LZ1DPN/NorCal-NC40a/26992727_10215181009948796_1139771007666521038_n.jpg

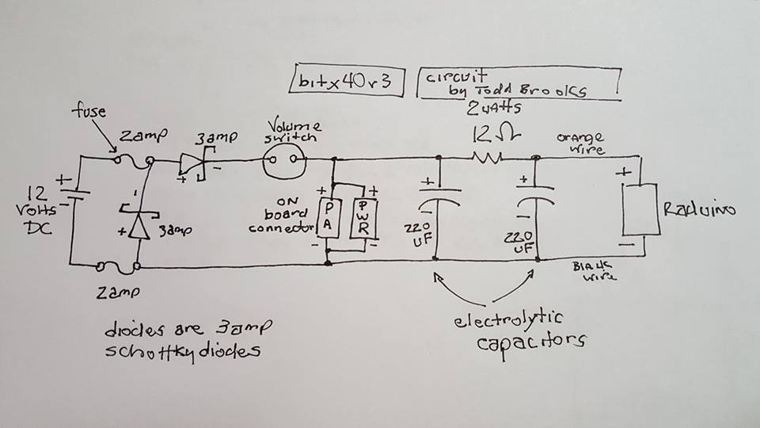
26992727_10215181009948796_1139771007666521038_n.jpg
