LZ1DPN/NorCal-NC40a/57180155_10156552755973757_5705052471420780544_n.jpg

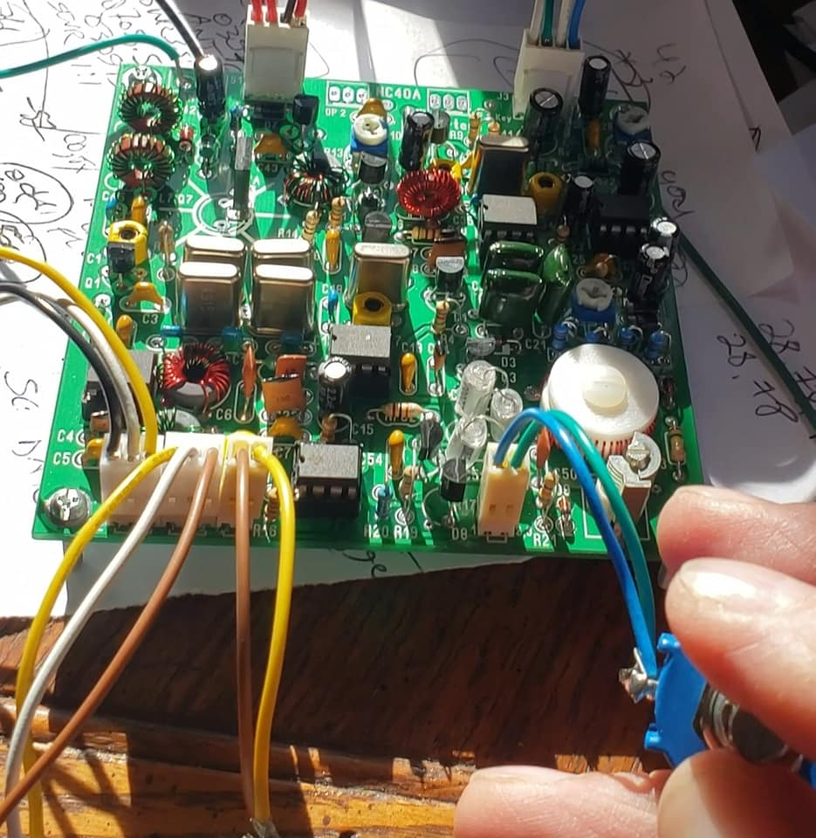
57180155_10156552755973757_5705052471420780544_n.jpg
