LZ1DPN/NorCal-NC40a/nc40a/qrp-tech-nc40a-schematic.pdf

Product Oet.

## and BFO

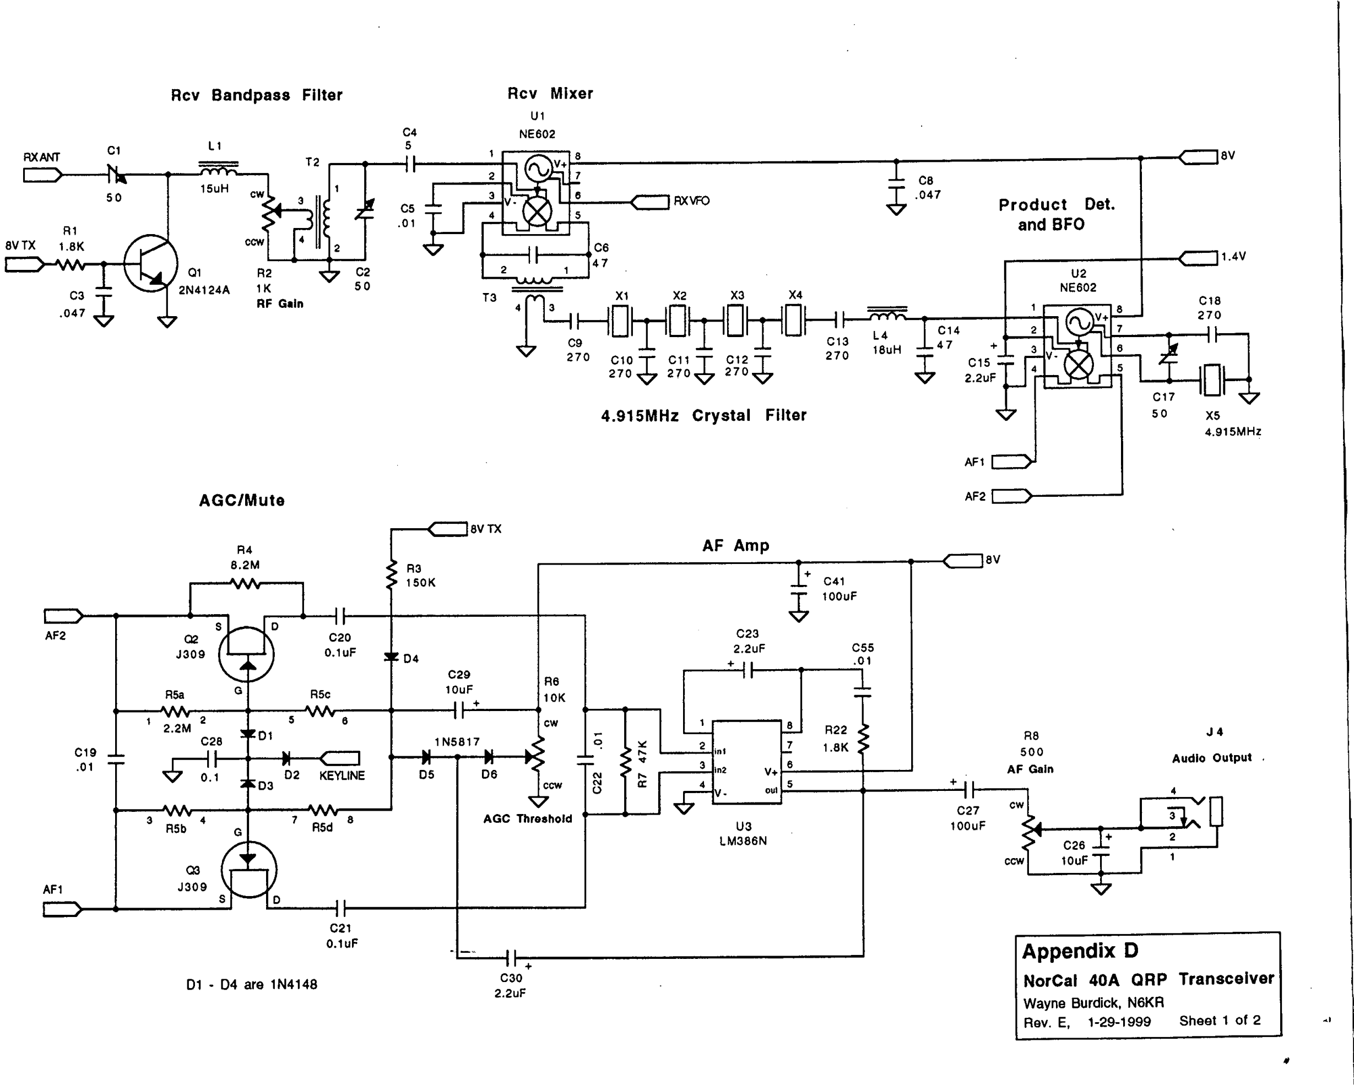
[picture p3: page 1]

1.4V

8V

X5
4.915MHz

C18
270
D~

U2
NE602

AF1

C14
47

C8
.047

~

~

RXVFO

## 4.915MHz Crystal Filter

## Rcv Mixer

U1
NE602

2
~

# "~t1~,r~,r~,rD~;:

270~ | 270~ | 270~

C2
50

T2

R2
1K
RF G.ln

cw 15uH

01
2N4124A

L1

## Rcv Bandpass Filter

C1

50

AGC/Mute | AF2

J4

Audio Output

R8
500
AF Gsln

8V

C27
100uF

+

C55
.01

R22
1.8K

+ C41
100uF
~

6

8

7

OUl,5

V+

C23
2.2uF
+

U3
LM386N

## AF Amp

~•... ..

•...
cr:

o
'"
'"o

R6
10K

cw

AGe Threshold

8VTX

C29
10uF
+

R3
150K

04

7 R5d' 8

### RSa

2.2M

3 A5'b' 4

C19
.01

AF2

AF1

C21
0.1uF

### 01 • 04 are 1N4148

+
C30
2.2uF

# Appendix D

## NorCal 40A QRP

### Wayne Burdick, N6KR Rev. E, 1-29-1999

## Transceiver

Sheet 1 of 2 | .1

II

,
~-

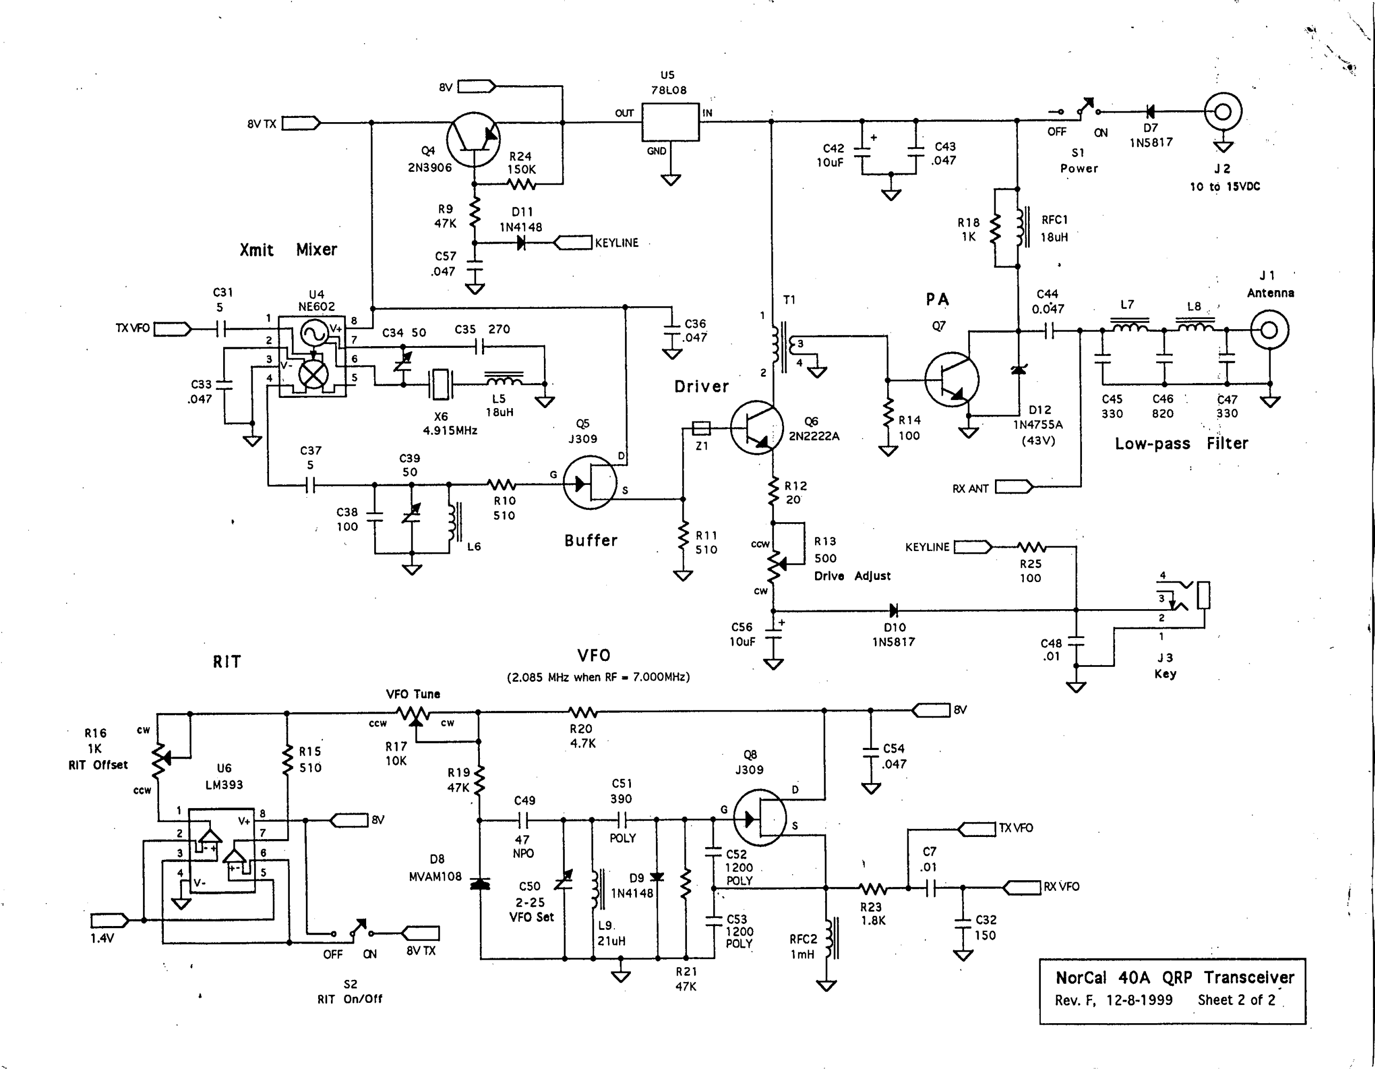
[picture p4: page 2]

, .

~.~~~

;~, -,,\.

J 1
Antenna
Low-pass | Fiher
. ~ | ~
(lIl | 07 | '.'

J2
| | 10 to 15VDC

OFF

51
Power

II

RFCl
, 18uH

012
1N4755A
(43V)

R18
lK

RXANT

PA

Q7

Rll
510

## Buffer

## VFO

(2.085 MHz when RF - 7.000MHz)

Rl0
510 II

L6

8Ve:=)

us
i | 78L08
R24 | I

~"
1
GND | C42
150K | 10uF

## 'VVv

011
lN4148

C57

# -4I--C:J KEYLINE

.047 ~

C35 270

# ' I Tl

I

...•..•C36

o~l;q J..047

I | Driver
X6 | 18uH
Q5

m I Zl

G | .
5

### VFO Tune

C38
100

## Xmit Mixer

8VTX

## RIT

C33
.047

08
MVAM108

R20
4.7K

C50
2-25

### VFO Set

R19
47K

cw

R17
10K

fN

ccw

-<=I

8VTX

R15
U6 | 510
LM393

cw

ccw

R16
lK

### RIT Offset

52
RIT On/O't

R21
47K
