LZ1DPN/NorCal-NC40a/nc40a/_Crystal%20Motional%20Parameters.pdf

Crystal Motional Parameters
A Comparison of Measurement Approaches

Jack R. Smith K8ZOA

### 11 June 2006

This paper compares results of a variety of alternative techniques to measure the motional parameters of a quartz crystal.

The measured crystal is a Saunders & Associates Reference Crystal, model 7000022, with the following parameters, as characterized with an S&A 250B automated parameter test set:

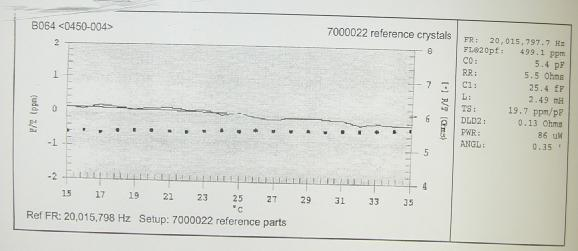
[picture p5: figure]

The key parameters for our purpose are:

C0: Static (holder) capacitance C1: Motional capacitance
L: Motional inductance
RR: Motional resistance

In this study, the motional parameters will be identified with the subscript M, e.g., CM.

The reference crystal has the following features:

- 20 MHz AT cut fundamental mode crystal
- Low aging design (<0.5ppm/year)
- Zero temperature coefficient at room temperature

All errors are calculated with respect to the parameters provided by S&A.

The following table summarizes the results of 18 measurements:

M

e

t

h

od

Test Number

Fixture

Methodology

Co (pF)
C1 (fF)

L1 (mH)

R1 (ohms)

C1 Error %

R1 Error %

Saunde

r

s

& As

s

o

cia

t

es
Cali

b

r

a

tion

S

tanda

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
5.4 25.4

2

.49

5.5

Std

Std
Boon

ton 250R

X

M

e

t

e

r C0
only @

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
G3UUR

2

N

/

A

1 | -- | 24

.73

2

.65 --

2

.6% --
09

Jun

Pi Fix

t

u

r

e

&

H

P8752B

3

a

2

5

.46 25

.987

2

.433

6

.77

2

.3% 23.1%
50 O

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
P8752

B

4

d

2 | -- | 28
.91 | --

6

.5275 13

.8% 18.7%
Pi fix

t

u

r

e

S

N

-002

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
P8752

B

5

a

2 | -- 26
.446 | --

6

.392

4

.1% 16.2%
87510

A

wit

h Fix

t

u

r

e

S

N

-001,
300

K

H

z

Span,

A

U

TO

mode

6

a

5 | -- 25
.883

2

.4475

6

.6023

1

.9% 20.0%
87510

A

wit

h Fix

t

u

r

e

S

N

-001,
10

K

H

z

span, po

w

e

r out: +20
d

B

m

7

a

5 | -- 26
.463

2

.3892

6

.65

4

.2% 20.9%
87510

A

wit

h Fix

t

u

r

e

S

N

-001,
10

K

H

z

span, po

w

e

r out: +10
d

B

m

8

a

5 | -- 26
.468

2

.3888

6

.644

4

.2% 20.8%
87510

A

wit

h Fix

t

u

r

e

S

N

-001,
10

K

H

z

span, po

w

e

r out: 0
d

Bm
9

a

5 | -- 26

.455

2

.39

6

.665

4

.2% 21.2%
87510

A

wit

h Fix

t

u

r

e

S

N

-001,
10

K

H

z

span, po

w

e

r out:

-10
d

B

m | 10

a

5 | -- 26
.479

2

.3889

6

.659

4

.2% 21.1%
Fix

t

u

r

e

S

N

-002

,

H

P8752

B,
+/
- 45 deg

ree

m

e

thod | 11
a
3 | -- | 26
.26 | --

6

.659

3

.4% 21.1%
Re

mea

s

u

r

e 50 ohm
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
P8752B 12

d

3 | -- 28
.872 | --

3

.72 13

.7%

-32.4%
12.5 O

h

m

Xfmr

Fix

t

u

r

e,
H

P8752

B | 13

b

3 | 50

.55

2

.719 99

.0%

-50.6%
50 oh

m

die-c

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
with
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
B pad

s

(ou

t

),
0

d

B

m ou

t

o

f

H

P8752

B

,

+

/-
45 deg

ree ph

a

s

e

m

e

thod 14

c

3 | 25

.792

6

.2916

1

.5% 14.4%
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
s 14,

e

x

cept
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
s and

c

alc

ula

te
ba

s

e

d on C0;

shun

ting

C only
C0 and

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
e | 15

c

3 | -- | 28
.65 | -- | -- 12
.8% | --
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
s 15, but

with
kno

w

n 10.11

pF

shun

ting
capa

cit

o

r | 16

c

3 | -- | 28
.50 | --

5

.83 12

.2%

5.9%
H

P8752

B, 10

d

B pad

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
-002,

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
tion

m

e

thod

,

L

m

via Q
mea

s

u

r

e

men

t | 17

a

3 | -- | 26

.15

2

.42

6

.18

2

.9% 12.3%
Re

sis

tan

c

e only

via

r

e

fle

c

tion,
H

P8752

B | 18

f

6

6

.82 -- 24.1%

Fixture a 12.5 ohm resistive pi b 12.5 ohm transformer
c 50 ohm - no transformer
d 50 ohm transformer
e Reflection holder

Methodology 1 G3UUR Oscillator frequency shift 2 +/- 45 degree phase shift
3 -3 dB bandwidth

### 4 series and parallel resonance 5 HP87510A Automatic characterization 6 Reflection measurement

The methodologies and test fixtures are described in more detail later in this document.

The following test equipment was used in these tests:

HP8752B network analyzer, 300 KHz-3 GHz, with Minicircuits model UNMP-5075 75 ohm : 50 ohm matching pads
HP87510A gain/phase analyzer, 100 KHz – 300 MHz
Miscellaneous Minicircuit 50-ohm standards and pads, and miscellaneous adapters and cables. Boonton RX meter Type 250A
HP 6205C DC power supply
Heath IM-2420 frequency counter
BP Model DCM-601 digital capacitance meter

Homebrew G3UUR oscillator
Homebrew test fixtures as described.

## Part I – Measurement Methodologies

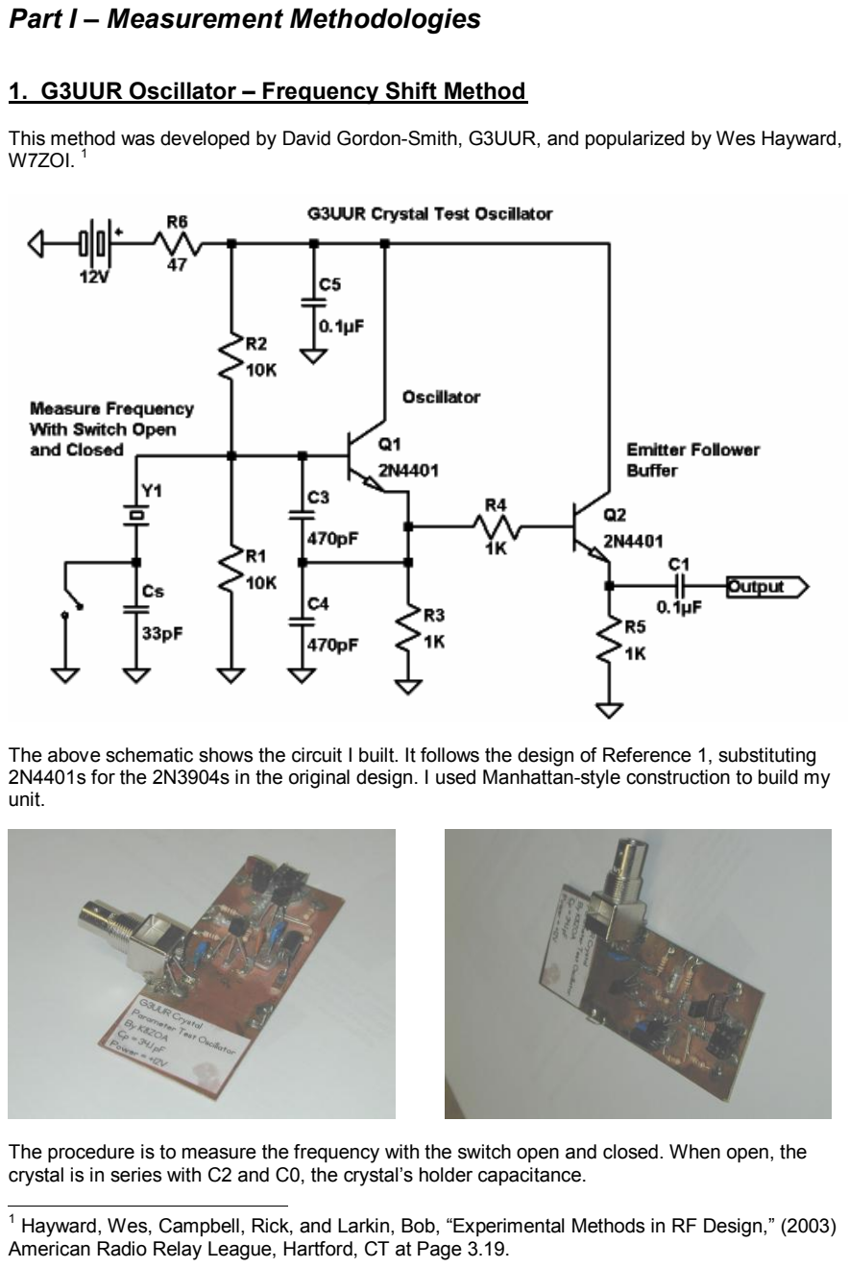
[picture p6: page 4]

### 1. G3UUR Oscillator – Frequency Shift Method

This method was developed by David Gordon-Smith, G3UUR, and popularized by Wes Hayward, W7ZOI.

1

The above schematic shows the circuit I built. It follows the design of Reference 1, substituting 2N4401s for the 2N3904s in the original design. I used Manhattan-style construction to build my unit.

The procedure is to measure the frequency with the switch open and closed. When open, the crystal is in series with C2 and C0, the crystal’s holder capacitance.

1 Hayward, Wes, Campbell, Rick, and Larkin, Bob, “Experimental Methods in RF Design,” (2003) American Radio Relay League, Hartford, CT at Page 3.19.

To calculate the motional parameters, use the following equations:

f

C C f
C

S
M

+ D
=

2( ) 0

M

M
f C
L | 2
(2 )
| 1
p

=

Cs should also include the strays associated with the switch and wiring. I measured Cs=34.1 pF in my oscillator. (To reduce stray capacitance, I used a two-pin header and shunt jumper instead of a standard switch.)

C0 is the crystal holder capacitance.

Δf is the shift in frequency between switch open and switch closed

f is the frequency with switch closed.

Remember to use proper units; capacitance is in farads (1pF = 10⁻¹² Farads), f and Δf are in Hz, Lm is in Henries.

Sample calculation with S&A calibrated crystal:

Measured Parameters
Switch closed: 20016843 Hz
Switch open: 20023109 Hz
Δf = 6266 Hz
C0 = 5.52 pF = 5.52*10⁻¹² F | (measured with Boonton model 250A RX meter at 1 MHz)
Cs = 34.1 pF = 34.1*10⁻¹² F | (measured with BP model DCM-601 digital capacitance meter)

Calculated Parameters

CM | 24.73 10 F 24.73 fF
20016843
2 (5.52 10 | 34.1 10 ) 6266 | 15
12 | 12
= | × | =
× | × | + | × | ×
=

LM

2.56 10 H 2.56mH
(2 | 20016843) 24.73 10
1 | 3
2 | 15 = | × | =
× × | × | ×

=

p

A useful unit for motional capacitance is the femto farad, where 1000 fF = 1pF.

We may compare the measured parameters with the calibration information:

Parameter | Measured | Calibration Standard | Error
Cm | 24.73 fF | 25.4 fF | -2.6%
Lm | 2.56 mH | 2.49 mH | +2.8%
C0 | 5.52 pF | 5.4 pF | +2.2%
Rm | Not measured | 5.5 ohms | N/A

### 2. Phase Shift Measurement

The method recommended in international standards is to install the crystal in a low impedance test fixture, fed with an accurate, stable signal generator and measure the phase shift of the transmission signal near resonance.

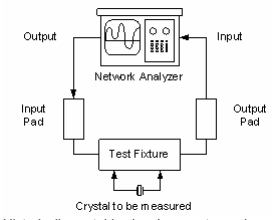
[picture p7: figure]

Historically, a stable signal generator and a vector voltmeter have been used to measure the phase of the transmission signal. In my case, I used either an HP8752B network analyzer, or an HP87510A gain/phase analyzer to generate the signal and measure the amplitude and phase of the transmission signal.

Methodology and Equations

The figure to the
right shows the
amplitude (top
panel) and phase
(bottom panel) of
the S&A calibration
crystal in Fixture
(a), the 12.5 ohm
resistive pi design

The bottom trace
has markers at the
+45 and –45 degree
points.

The +45 degree
point is at –972 Hz
below the zero
angle reference,
whilst the –45
degree point is
1109 Hz above the
zero reference.

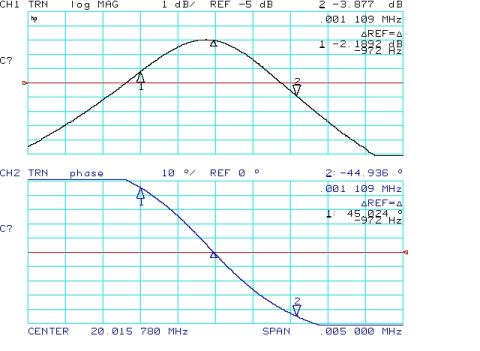
[picture p8: figure]

The ±45 degree bandwidth is thus 2081 Hz.

We also use the same
setup to measure Rm,
by measuring the
insertion loss at the
zero phase point.

When phase = 0
(marker 2), the
insertion loss is
2.01131 dB.

Note that the zero
phase point is not the
minimum loss point.
In fact, the two are 89
Hz separated in this
measurement.

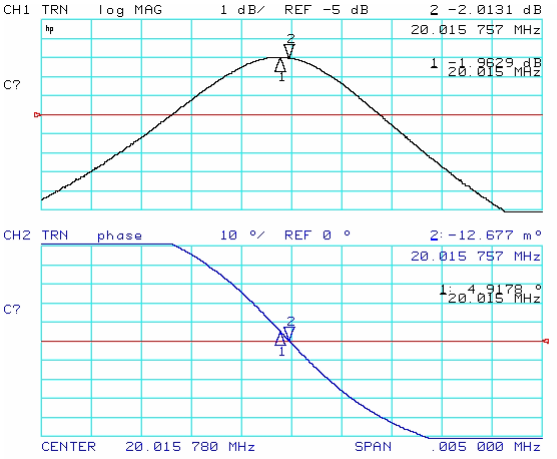
[picture p9: figure]

The relationship between attenuation and series resistance is:

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
= 2 | 10 -1
| 20

a
RM RL

Where

RM is the motional resistance
RL is the source and load resistance seen by the crystal (a function of the test fixture) α is the loss in dB

Applying the measured data, we calculate RM:

= W ÷

÷
ø

ö
ç

ç
è

æ
= 2×12.5× 10 | -1 | 6.521 ²⁰

2.0131
R M

The total resistance, REFF, seen by the crystal is the sum of the load resistance (input and output) and the motional resistance, RM:

REFF = 2 RL + RM = 2 * 12.5 * 6.52 = 31.52 Ohms.

The following formulas may be used to compute the motional parameters.

2 | tan( ) ( )

2

p | J J
R | EFF

M
f R

f
C

D ±
=

tan( )
2 ( )

J

### pD ±j

=
f

R
L

EFF
M

The standard calls for measurement at the ±45°, so φ = 45°

Where

Δf is the frequency diffrerence between the ±45° points, measured at 2081 Hz. φ = 45°, so tan(45) = 1.
REFF = 31.52 ohms, as determined above
fR is the series resonant frequency, i.e., the frequency at which φ=0°.

We now calculate the motional parameters:

CM

26.23 10 F 26.23 fF
2 | 20015757 31.52 1
2081 | 15

2

= | × | =
× × | × | ×

=

p

LM

1 2.411 10 H 2.411mH
2 | 2081
31.52 | 3
× = | × | =
× ×

=

p

We now compare these measured values with the calibration standard:

Parameter | Measured | Calibration Standard | Error
Cm | 26.23 fF | 25.4 fF | +3.3%
Lm | 2.411 mH | 2.49 mH | -3.2%
C0 | Not measured | 5.4 pF
Rm | 6.52 | 5.5 ohms | +18.5%

3. -3 dB Bandwidth Method

Measuring the ±45°
bandwidth requires
equipment not
easily available to
all experimenters.²

It’s also possible to
derive motional
parameters from a
3 dB bandwidth
measurement. This
may be made with
much simpler
equipment.

The figure at the
right shows the
-3dB bandwidth
data for the
calibration crystal.
The crystal is
installed in the type
(a) 12.5 ohm
resistive pi fixture.

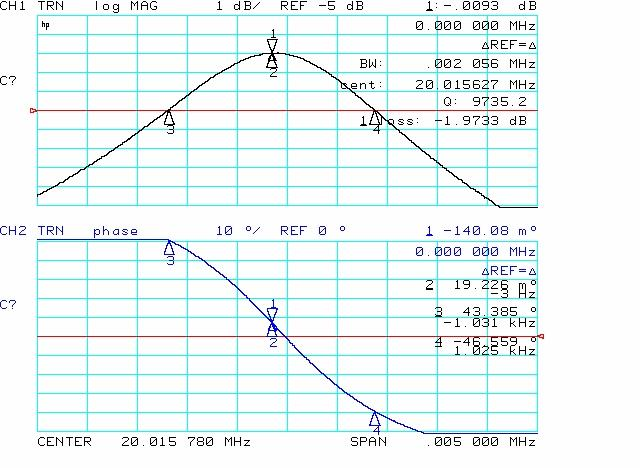
[picture p10: figure]

The network analyzer calculates the 3 dB bandwidth as 2056 Hz, and the measured Q as 9737.5,with a center frequency of 20.015627 MHz. The attenuation at the point of minimum loss is 1.9733 dB.

We base the motional parameter calculation on the definition of Q:

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
Solving for LM we find:

R

EFF
M
f

QR L
2p

=

Where

REFF is the effective series resistance seen by the crystal, RM + 2 * RL.
fR is the series resonant frequency, i.e., the frequency of minimum loss, 20.015627 MHz.
Δf is the –3dB bandwidth, displayed as 2056 Hz.
Q is the ratio of fR to the –3dB bandwidth, displayed as 9737.5 (or can be calculated as 20015627 / 2056 = 9735)

2
See K8IQY’s low-cost approach to 3 dB crystal parameter measurements at http://www.k8iqy.com/testequipment/pvxo/pvxopage.htm and http://www.k8iqy.com/testequipment/pvxo/Atlanticon2002V1R5.pdf.

R M

M
f L
C | 2 | 2
4

1
p

=

Using the methodology described before, we calculate RM and REFF using the measured 1.9733 dB loss at the center frequency.

RM = 6.38 ohms, REFF = 31.38 ohms.

Calculating LM:

LM

2.429 10 H 2.429mH
2 | 20.015627 10
9737.5 31.38 | 3

6

= | × | =
× × | ×

×
=
p

CM

26.03 10 F 26.03 fF
4 | 20015627 2.429 10
1 | 15
2 | 2 | 3
= | × | =
× × | × | ×

=

p

We now compare these measured values with the calibration standard:

Parameter | Measured | Calibration Standard | Error
Cm | 26.03 fF | 25.4 fF | +2.5%
Lm | 2.429 mH | 2.49 mH | -2.4%
C0 | Not measured | 5.4 pF
Rm | 6.38 | 5.5 ohms | +16.0%

### 4. Series and Parallel Resonant Frequencies

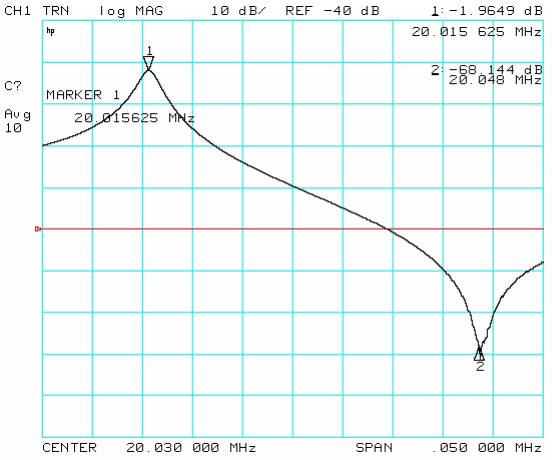
[picture p11: figure]

A variant on the
two frequency
method used in
the G3UUR
oscillator is to
measure the
series and
parallel resonant
frequencies of the
crystal, and from
their ratio
determine the
motional
parameters.

The figure at the
right shows the
series fS (at
marker 1) and
parallel fP (marker
2) resonant
frequencies of the
calibrated crystal.

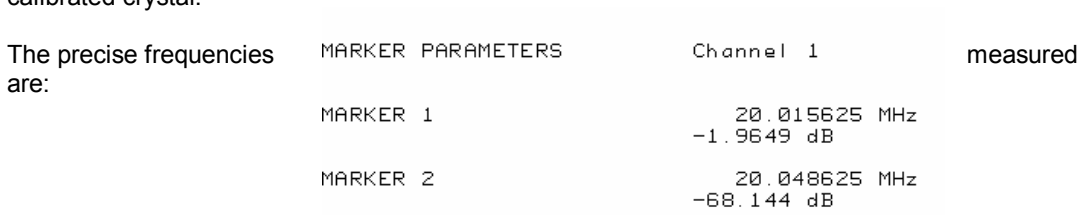
[picture p12: figure]
The precise frequencies; measured; are:

The relationship between motional parameters and the series and parallel resonant frequencies is:

1 2( | ) 0 | STRAY

S

P
M | C C
f

f
C | + ÷

÷
ø

ö
ç

ç
è

æ
= | -
R | M

M
f C
L | 2 | 2
4

1
p

=

Where

fP and fS are the parallel and series resonant frequencies as described above
C0 is the holder capacitance
CSTRAY is the stray shunting capacitance of the test fixture

To measure CSTRAY, we determine the attenuation through the test fixture with the crystal removed.

Assuming that the stray capacitance is small, we can use the attenuation to determine the corresponding capacitive reactance and from that the value of Cstray.

With the crystal
removed, the
attenuation has a
mean value of 44.3
dB at 20.03 MHz.

This corresponds to a
capacitive reactance
of 4.08 K ohm,
corresponding to1.95
pF stray capacitance
shunting the crystal
socket.

As previously
mentioned, measuring
the calibrated crystal
at 1.0 MHz with a
Boonton 250 RX
meter showed the C0
= 5.61 pF.

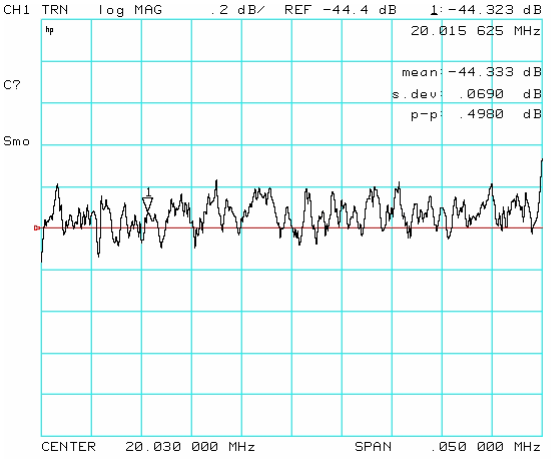
[picture p13: figure]

Hence, C0 + CSTRAY = 5.52 + 1.95 pF = 7.47 pF.

We now are in a position to calculate the motional parameters:

CM | 1 2 7.47 pF 24.63 fF
20015625
20048625 ÷× × | =
ø

ö
ç
è

æ
= | -

LM

2.57mH
4 20015625 24.63 10

1
2 | 2 | 15 =
× × | × | ×
= | -
p

We now compare these measured values with the calibration standard:

Parameter | Measured | Calibration Standard | Error
Cm | 24.63 fF | 25.4 fF | -3.0%
Lm | 2.57 mH | 2.49 mH | +3.2%
C0 | 5.61 | 5.4 pF | +3.9%
Rm | 6.35 | 5.5 ohms | +15.4%

(Rm is computed from the marker 1 attenuation value of 1,9649 dB)

When
measuring the
series and
parallel
resonant
frequencies, be
sure you don’t
inadvertently
measure a
spurious
resonance, as
most crystals
exhibit several
spurious
resonance
points above
the true parallel
resonance
point.

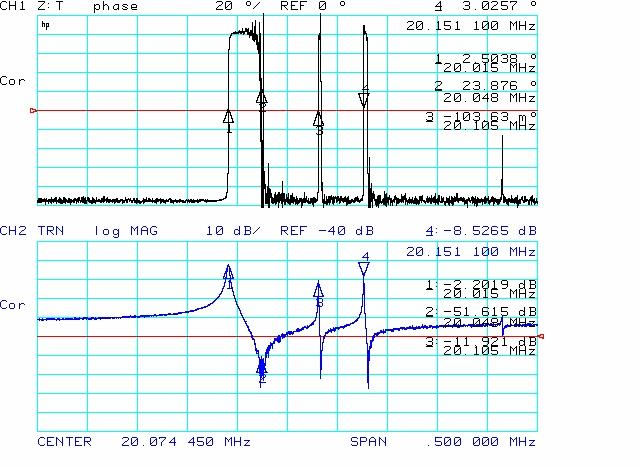
[picture p14: figure]

The calibrated crystal, for example, shows two major and one minor spurious resonance points.

### 5. HP87510A Automatic characterization

The HP87510A gain/phase analyzer
has an internal firmware crystal
resonator characterization routine that
computes and displays a six-parameter model. To use the automatic characterization function, the crystal must be installed in a transmission fixture.

The primary advantage of the 87510A’s automatic characterization function is that its analysis is based
upon curve fitted data involving at
least 8 measurement points. It thus

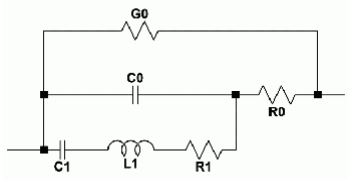
[picture p15: figure]

offers the prospect of increased accuracy by leveraging multiple data points.

The 87510A’s Operation Manual describes the methodology used to calculate the six parameter values:

1. Obtains the admittance characteristic circle diagram
2. Obtains the maximum conductance (Gmax)
3. Obtains frequencies f1 and f2 (f1<f2) of two points where conductance is half the maximum

conductance.

4. Calculate fs by | 1 | 2
f | f f
s = | ×
5. Obtains susceptance Bfs at fs
6. Calculate ωS by S | S w = 2p f
7. Assumes that the frequency at which the phase difference becomes 0° near the parallel

resonance frequency is fa and obtains its conductance Ga.

8. Calculate ωa by

### a a w = 2p f

9. Assumes that the frequency at which the phase difference becomes 0° near the series

resonance frequency is fr

10. Calculates the constants using the above values and the following equations:

2 1

f f

f
Q | S
S | -

=

S

B B
C
2w
' | 1 | 2
0

+
=

max

1 | G

Q
L

S

| S
w

=

0 max

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
1 = | 1

max

0

1
R
G

R = -

S

Bfs C
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
1 R R C

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
Applying these equations by pressing the 87510A’s appropriate soft key produced the following motional parameters and errors:

Parameter | Measured | Calibration Standard | Error
Cm | 25.883 fF | 25.4 fF | +1.9%
Lm | 2.4475 mH | 2.49 mH | -1.7%
C0 | N/A | 5.4 pF
Rm | 6.60 | 5.5 ohms | +20.0%

The measured parameters are sensitive to the span used and the above data represents the best case. Other 87510A measurements are summarized in the measurement table and display errors up to 4.2%.

### 6. Reflection Resistance Measurement

The final measurement approach was an attempt to resolve the wide gap between the reference crystal’s stated motional resistance of 5.5 ohms, whilst all my measurements were in the range 6.3 to 6.8 ohms, with 6.6 ohms being the most common value.

In this mode, the network analyzer is successively calibrated, at the reflection measurement port, with an open, short and load (50 ohm) standard. The unknown is attached to the reflection measurement port and the instrument set to internally convert the complex reflection coefficient to either Z/theta or R and jX values.

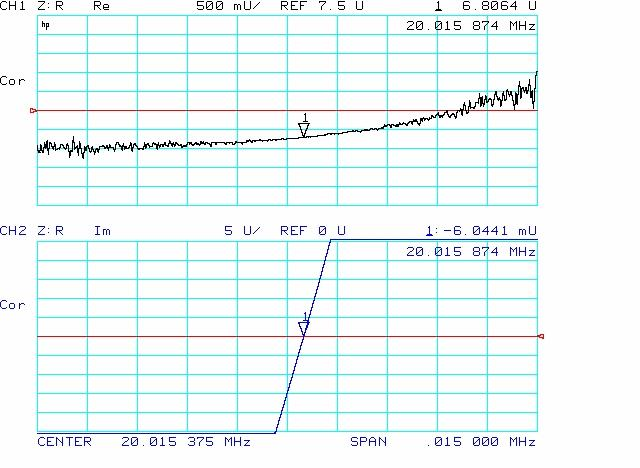
[picture p16: figure]

The data confirms the transmission-mode values in the 6.5 ohm range. At the point where the imaginary (reactive) part of the impedance is zero, the real (resistive) value is 6.8 ohms.

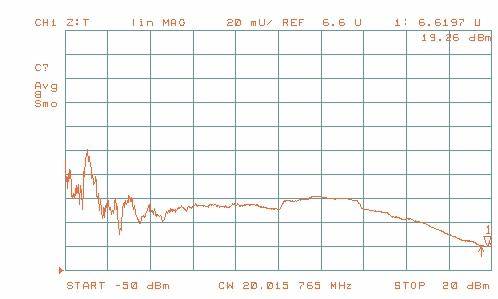
[picture p17: figure]

Some
crystals
exhibit
significant
change in
motional
resistance
as drive
level
changes.
To test this
as a
possible
reason for the consistent divergence between measured and calibration motional resistance, I ran a power sweep test using the HP87510A gain/phase analyzer.

As shown, over the range -50 dBm to +20 dBm, RM changes less than 0.04 ohms and stays in the 6.6 ohm range.

The crystal is held in a (a) type resistive fixture, with 10 dB attenuation between the 87510A’s output and the fixture.

The extra attenuation, plus the fixture’s loss, means that the power delivered to the crystal is much less than the 87510A’s output shown on the horizontal axis. +20 dBm corresponds to approximately 4 mA crystal current, or about 100 microwatts.

Marker 1, at +19.26 dBm corresponds to 88 microwatts, the power level at which the calibrated crystal was tested by S&A. The measured value at this point is 6.62 ohms.

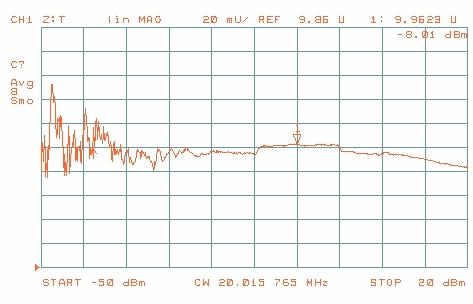
[picture p18: figure]

To verify the accuracy
of the power sweep
and test fixture, I
substituted a 1% 10
ohm, 1206 surface
mount resistor for the
test crystal.

Although there is
some variation, the
87510A results are
quite close to the test
resistor’s 10.0 ohm
market value.

At DC, a four-wire
measurement shows
the test resistor is
10.03 ohms.

## Part II – Test Fixtures

I built and used five test fixtures:

(a) Resistive Pi Fixture:

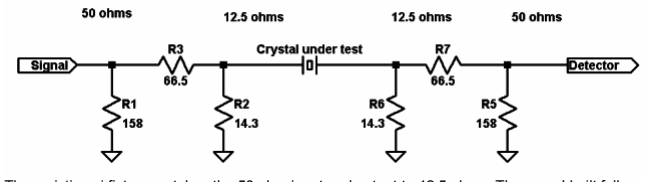
[picture p19: figure]

The resistive pi fixture matches the 50 ohm input and output to 12.5 ohms. The ones I built follow the standard design in IEC standard, except that the phase compensation trimmers across the 14.3 ohm resistors are not used and I used the
nearest 1% standard resistor values.

The photo to the right shows the prototype pad
unit I built, using Manhattan-style construction. The pad is constructed with re 1%, 1206 size surface mount resistors.

It’s important to shield the input and output ports.

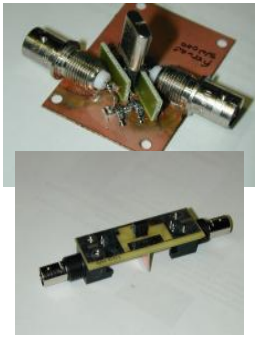
[picture p20: figure]
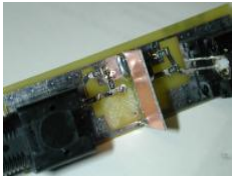
[picture p21: figure]

The three photos show the printed circuit version of the prototype.

The resistors provide a reasonably good impedance match and hence external stabilizing pads are less necessary than for other fixtures.

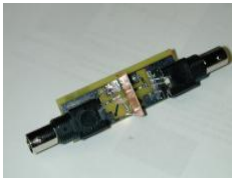
[picture p22: figure]

(b) Transformer Pi Fixture

In addition to a resistive pad matching approach, it’s possible to use a 2:1 winding transformer to provide a 50ohm to 12.5 ohm impedance transformation.

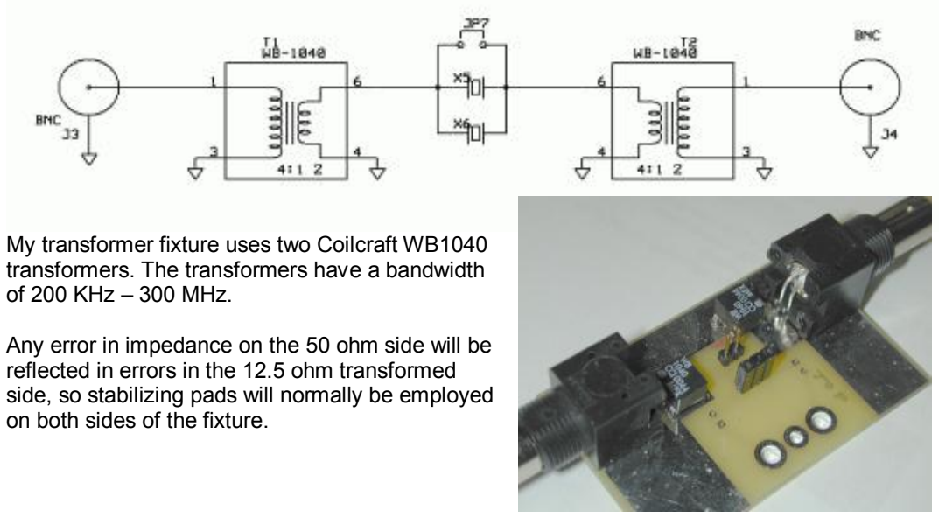
[picture p23: figure]
of 200 KHz – 300 MHz.; on both sides of the fixture.

My transformer fixture uses two Coilcraft WB1040 transformers. The transformers have a bandwidth

Any error in impedance on the 50 ohm side will be reflected in errors in the 12.5 ohm transformed side, so stabilizing pads will normally be employed

(c) 50 Ohms, no Matching, no Loss

The simplest fixture simply breaks the connection between signal generator and receiver and inserts the crystal.

I built one into a Hammond die-cast box and brought the connections out to binding posts.

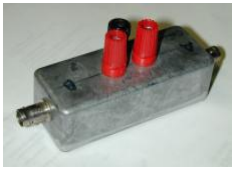
[picture p24: figure]

In order to accurately compute the crystal motional parameters, it’s important that the impedance seen by the crystal be accurately known. With a simple fixture of this type, it’s important to use pads on both the input and output in order to provide accurate and stable impedance.

(d) 50 Ohm Transformer Fixture

I also built a variant of the 12.5 ohm transformer fixture described at (b), but with Coilcraft model WB1010 transformers providing a 1:1 impedance ratio.

It is otherwise identical with the fixture discussed in section (a). This fixture is also to be used only with a controlled impedance environment, as the transformers reflect actual input and output impedance.

(e) Reflection Test Fixture

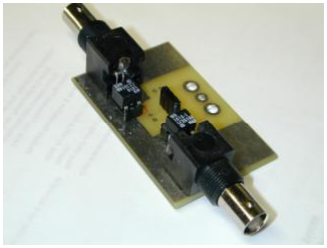
[picture p25: figure]
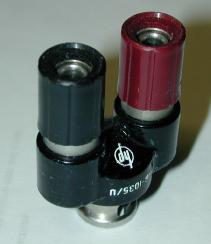
[picture p26: figure]

To measure RM via reflection, the reference crystal was attached to the 8752B network analyzer using a standard BNC-to-binding post adapter, HP model 10110A.
