LZ1DPN/NorCal-NC40a/nc40a/NorCal40A - US Ver. 1.6.pdf

Nov. 13th 2017
Version 1.6

### Bill of Material

NorCal 40 a – qrp-tech Build 2017 | by DM5TU & K7QO

NorCal40A - US Ver. 1.6, Page 1/2

Pos. | | | | P/N | | QTY
1 | OK | C4, C31, C37 | | 490-8706-ND | OK | 3
2 | OK | C6, C14, C49 | | 490-9110-1-ND | OK | 3
3 | OK | C49 alternativ | | 490-9110-1-ND | OK | 1
4 | OK | C38 | | 490-8960-1-ND | OK | 1
5 | OK | C32 | | 490-8646-ND | OK | 1
6 | OK | C9 - C13, C18, C35 | | 490-8672-ND | OK | 7
7 | OK | C45, C47 | | 490-8680-ND | OK | 2
8 | OK | C46 | | 490-9132-1-ND | OK | 1
9 | OK | C5, C7, C19, C22, C48, C55 | | 490-8634-ND | OK | 6
10 | OK | C3, C8, C33, C36, C43, C44, C54, C57 | | 445-173397-1-ND | OK | 8
11 | OK | | | 445-173396-1-ND | OK | 1
12 | OK | C51 | CAP, POLYSTYRENE, 390pF, 5% | | OK | 1
13 | OK | C52, C53 | CAP, POLYSTYRENE, 1200pF, 5% | | OK | 2
14 | OK | C20, C21, C28 | | 495-5055-1-ND | OK | 3
15 | OK | C15, C23, C30 | CAP, ELEC, 2.2µF, 50V | P15834CT-ND | OK | 3
16 | OK | C26, C29, C42, C56 | CAP, ELEC, 10µF, 50V | P19590CT-ND | OK | 4
17 | OK | C27, C41 | CAP, ELEC, 100µF, 50V | P19608CT-ND | OK | 2
18 | OK | C50 | CAP, VAR, 2-24pF, AIR | | | 1
19 | OK | C1, C2, C17, C34, C39 | | | | 5
20 | OK | D1, D2, D3, D4, D9, D11 | | 1N914FS-ND | OK | 6
21 | OK | D12 | DIODE, ZENER, 1N4755A 43V 1W | 1N4755A-ND | OK | 1
22 | OK | D5 – D7, D10 | DIODE, SCHOTTKY, 1N5817 | 1N5817-TPCT-ND | OK | 4
23 | OK | D8 | DIODE, VARACTOR, MVAM109 | | OK | 1
24 | OK | U3 | IC, AF AMP, LM386N | | OK | 1
25 | OK | U6 | IC, COMPARATOR, LM393N | LM393NFS-ND | OK | 1
26 | OK | U1, U2, U4 | IC, MIXER/OSC NE602N | NE602AN Mixer | OK | 3
27 | OK | U5 | IC, VOLTAGE REG,N78L08, 8V, TO-92 | 497-10099-1-ND | OK | 1
28 | OK | L1 | IND, CHOKE, 15µH | M8183-ND | OK | 1
29 | OK | L4, L5, RFC1 | IND, CHOKE, 18µH | M8184-ND | OK | 3
30 | OK | RFC2 | IND, CHOKE, 1mH | M8205-ND | OK | 1
31 | OK | L6 | | | OK | 1
32 | OK | L7, L8 | | | OK | 2
33 | OK | L9 | | | OK | 1
34 | OK | T1 | | | OK | 1
35 | OK | T2 | | | OK | 1
36 | OK | T3 | | | OK | 1
37 | OK | J3, J4 | JACK, 3.5mm Stereo | | | 2
38 | OK | J1 | JACK, BNC | | | 1
Checked Ref. | Description | Possible Source Checked
CAP, DISC or MONO, 5pF, 5%, 50V | Digikey
CAP, DISC or MONO, 47pF, 5%, 100V | Digikey
CAP, NP0 or C0G 47pF 5%, 100V | Digikey
CAP, DISC or MONO, 100pF, 5%, 50V | Digikey
CAP, DISC or MONO, 150pF 5%, 50V | Digikey
CAP, DISC or MONO, 270pF, 5%, 50V | Digikey
CAP, DISC or MONO, 330pF, 5% 50V | Digikey
CAP, DISC or MONO, 820pF, 5% 100V | Digikey
CAP, DISC or MONO, 0.01µF = 10nF, 5%, 50V | Digikey
CAP, DISC or MONO 0.047µF = 47nF, 10%, 100V | Digikey
Cz – Zobel filter (Add On) | CAP, DISC or MONO 0.1µF, 100nF, 10%, 100V | Digikey
390pF 5% 50 WV Polystyrene Caps | kitsandparts.com
1200pF 5% 50 WV Polystyrene Caps | kitsandparts.com
CAP, MYLAR or MONO, 0.1µF, 100nF | Digikey
Digikey
Digikey
Digikey
tbd
CAP, VAR, 8-50pF (may be MuRata cap 9-60pF) | tbd
DIODE, SWITCHING 1N914 or 1N4148 | Digikey
Digikey
Digikey
MVAM109 Varactor Diode | kitsandparts.com
LM-386N-4 Audio Amps | Kitsandparts.com
Digikey
Kitsandparts.com
Digikey
Digikey
Digikey
Digikey
IND, TOROID, 28turns 2,5 uH #28 T-37-2 | T37-2 powdered iron toroid | kitsandparts.com
IND, TOROID, 18 turns 1,3uH #26 T-37-2 | T37-2 powdered iron toroid | kitsandparts.com
IND, TOROID, 60 turns 21uH #28 T-68-7 | T68-7 powdered iron toroid | kitsandparts.com
IND, TOROID, 14 turns PRI, 4 turns SEC, #26, FT-37-43 | FT 37-43 ferrite toroid | kitsandparts.com
IND, TOROID, 20 turns SEC, 1 turn PRI, #26, FT-37-61 | FT37-61 ferrite toroid | kitsandparts.com
IND, TOROID, 23 turns PRI, 6 turns SEC, #26, FT-37-61 | FT37-61 ferrite toroid | kitsandparts.com
Junkbox
Junkbox

Nov. 13th 2017
Version 1.6

### Bill of Material

NorCal 40 a – qrp-tech Build 2017 | by DM5TU & K7QO

NorCal40A - US Ver. 1.6, Page 2/2

Pos. Checked Ref. | Description | P/N | Possible Source Checked | QTY
39 | OK | J2 | JACK, RCA | | | 1
40 | OK | | RES 10R, 1/4W, 5% | CF14JT10K0CT-ND | OK | 1
41 | OK | R12 | RES, 20R, 1/4W, 5% | 20QBK-ND | OK | 1
42 | OK | R14, R25 | RES, 100R, 1/4W, 5% | CF14JT100RCT-ND | OK | 1
43 | OK | R10, R11, R15 | RES, 510R, 1/4W, 5% | 510QBK-ND | OK | 3
44 | OK | R7, R9, R19, R21 | RES, 47K, 1/4W, 5% | CF14JT47K0CT-ND | OK | 4
45 | OK | R6 | RES, 4M7, 1/4W, 5% | CF14JT4M70CT-ND | OK | 1
46 | OK | R4 | RES, 8M2, 1/4W, 5% | CF14JT8M20CT-ND | OK | 1
47 | OK | R4 Alternativ | RES 15M. 1/4W, 5% | RNV14FAL15M0CT-ND | OK | 1
48 | OK | R8, R13 | | CT6EP501-ND | OK | 2
49 | OK | R2, R16 | | 987-1309-ND | OK | 2
50 | OK | R6 | | CT6EP103-ND | OK | 1
51 | OK | R17 | | 987-1308-ND | OK | 1
52 | OK | | | 3590S-2-103L-ND | OK | 1
53 | OK | R18 | RES 1K, 1/4W, 5% | CF14JT1K00CT-ND | OK | 1
54 | OK | R1, R22, R23 | RES 1k8, 1/4W, 5% | CF14JT1K80CT-ND | OK | 3
55 | OK | R20 | RES 4k7, 1/4W, 5% | CF14JT4K70CT-ND | OK | 1
56 | OK | R3, R24 | RES 150k, 1/4W, 5% | CF14JT150KCT-ND | OK | 2
57 | OK | R5 | | | | 1
58 | OK | R5a | | CF14JT2M20CT-ND | OK | 4
59 | OK | S1, S2 | | | | 2
60 | OK | Q1 | | 2N4124-ND | OK | 1
61 | OK | Q6 | | | OK | 1
62 | OK | Q7 | | | OK | 1
63 | OK | Q2, Q3, Q5, Q8 | TRANS, J310 | | OK | 4
64 | OK | Q4 | TRANS, 2N3906, TO-92 | 2N3906CS-ND | OK | 1
65 | OK | X1-6 | XTAL, 4.915Mhz, HC-49. MATCHED, +/- 20Hz | | | 6

Junkbox
Rz – Zobel filter (Add On) | Digikey
Digikey
Digikey
Digikey
Digikey
Digikey
Digikey
Digikey
RES, Trimmer, 500R | Digikey
RES, POT, 1K – Front panel | Digikey
RES, Trimmer, 10k | Digikey
RES, POT, 10k – Front panel | Digikey
R17a (extra for better tuning) | RES, POT, 10k, 10 Turns – Front panel | Digikey
Digikey
Digikey
Digikey
Digikey
8-PIN Network SIP 2.2M | tbd
4 x 2.2M 1/4W matched resistors vertically mounted | Digikey
SWITCH, SPDT, PC-MT, Right Angle | Junkbox
TRANS, 2N4124 or 2N3904, NPN transistor | Digikey
TRANS, 2N2222A plastic TO-92, not metal wid diff. Pin out | PN2222A NPN HF Amp | kitsandparts.com
TRANS, 2SC799 (MRF607,MRF237, 2N3553, D882 or
2N3866) | 2N3866 RF Amp | kitsandparts.com
J310 FET RF Osc/Amp | kitsandparts.com
Digikey
tbd

When checking your parts, use a highlighter pen to mark the OK in the check colums when you got them

To use the Digikey Shopping Basket use this link: http://www.digikey.de/short/q3tw1w | When at DigiKey.com select your country and your currency in the upper
right corner of the screen. Follow the instructions.
For Kits and Parts.com use this link: | http://kitsandparts.com/store2.php
When at KitsandParts.com you need to put the items in a new shopping basket
