LZ1DPN/NorCal-NC40a/0.jpg

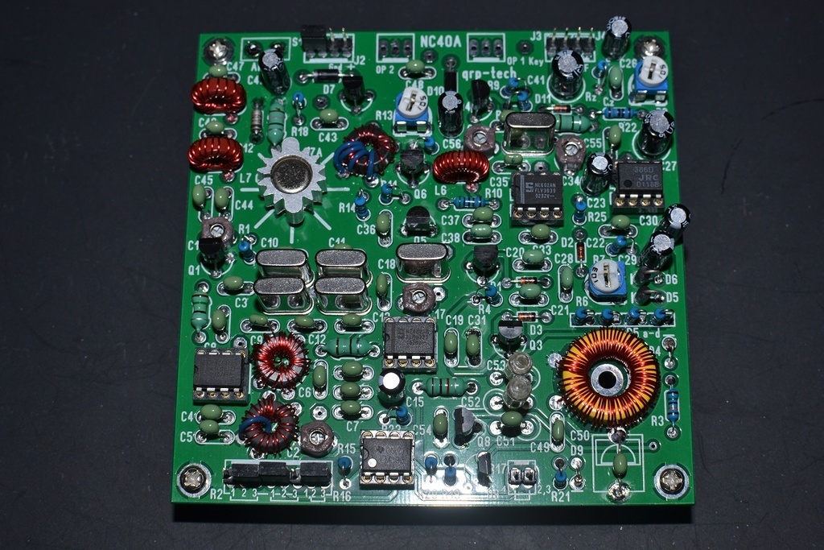
0.jpg
