LZ1DPN/NorCal-NC40a/k7qo-norcal40a-nr1.jpg

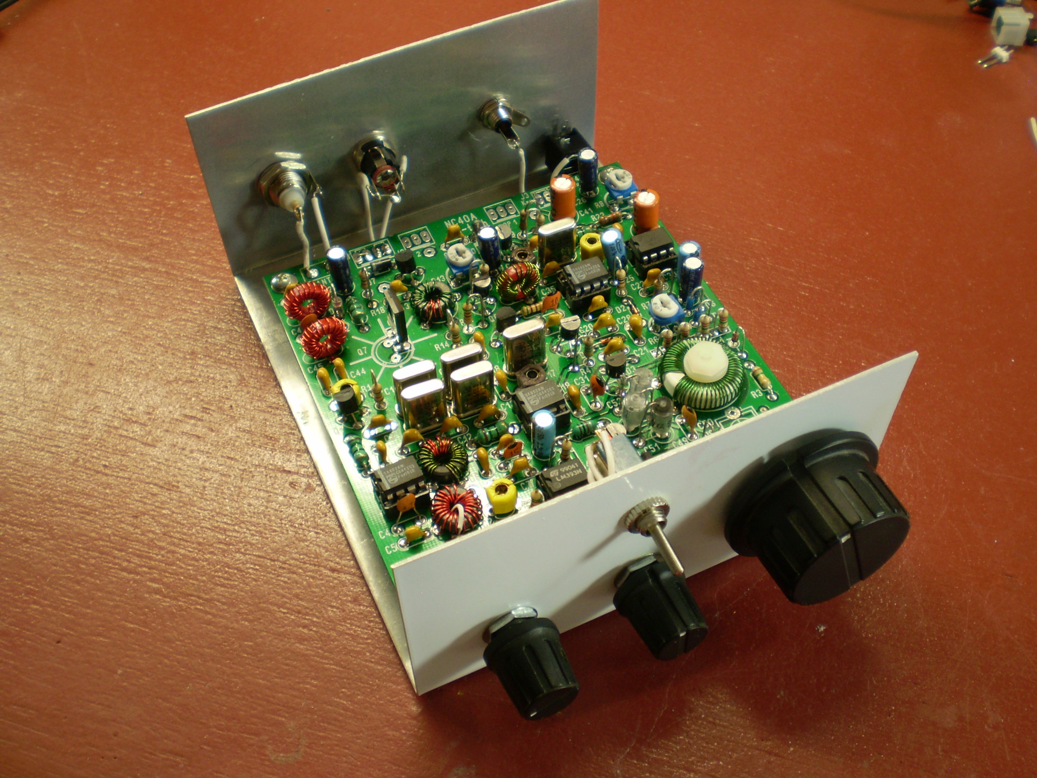
k7qo-norcal40a-nr1.jpg
