LZ1DPN/NorCal-NC40a/k7qo-norcal40a-nr2.jpg

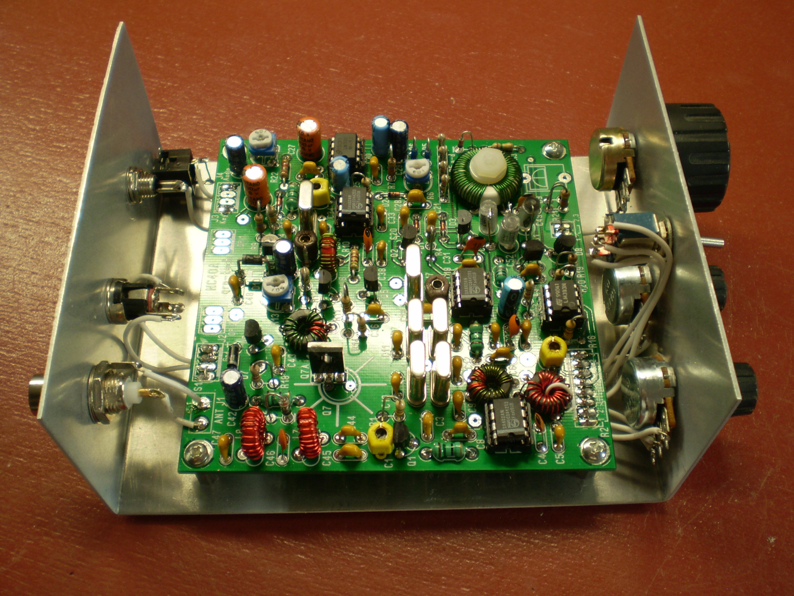
k7qo-norcal40a-nr2.jpg
