LZ1DPN/NorCal-NC40a/k7qo-norcal40a-nr4.jpg

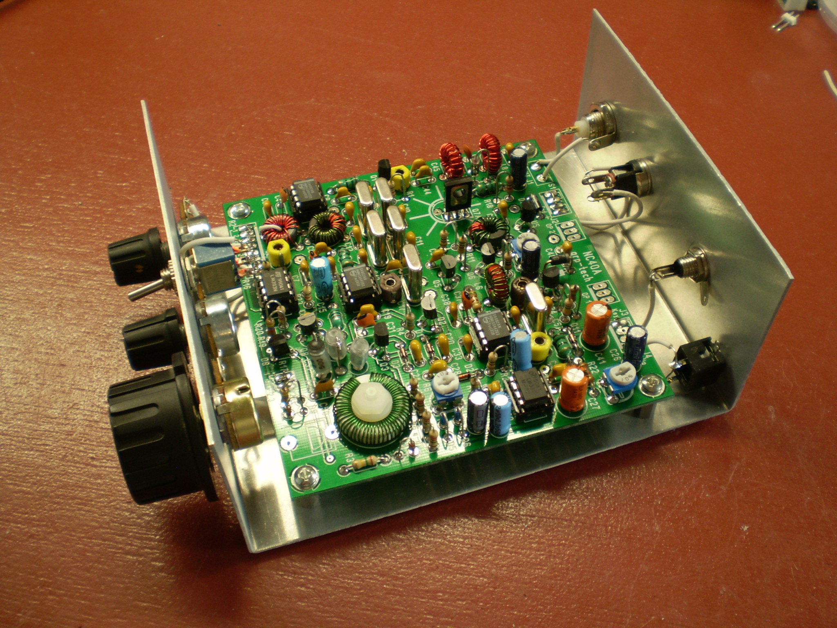
k7qo-norcal40a-nr4.jpg
