LZ1DPN/NorCal-NC40a/nc40a/NC40A-all-layers.jpg

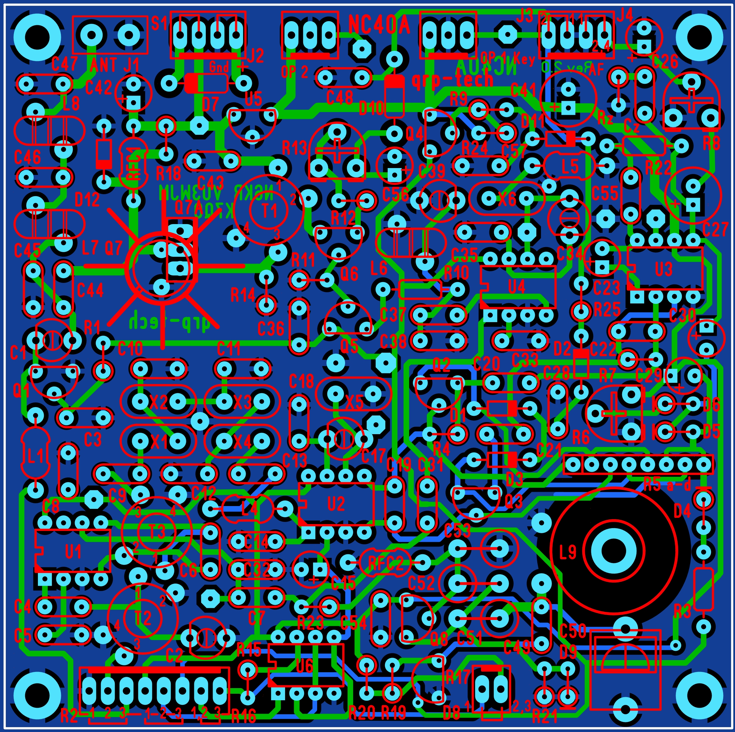
nc40a/NC40A-all-layers.jpg
