LZ1DPN/NorCal-NC40a/nc40a/NC40A_PCB_back.jpg

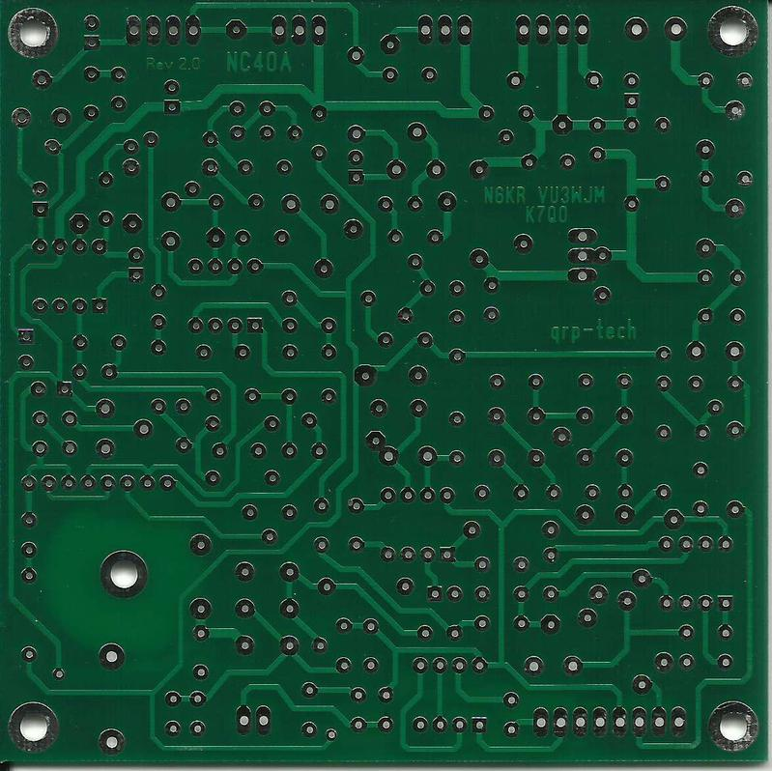
nc40a/NC40A_PCB_back.jpg
