LZ1DPN/NorCal-NC40a/nc40a/NC40A_PCB_front.jpg

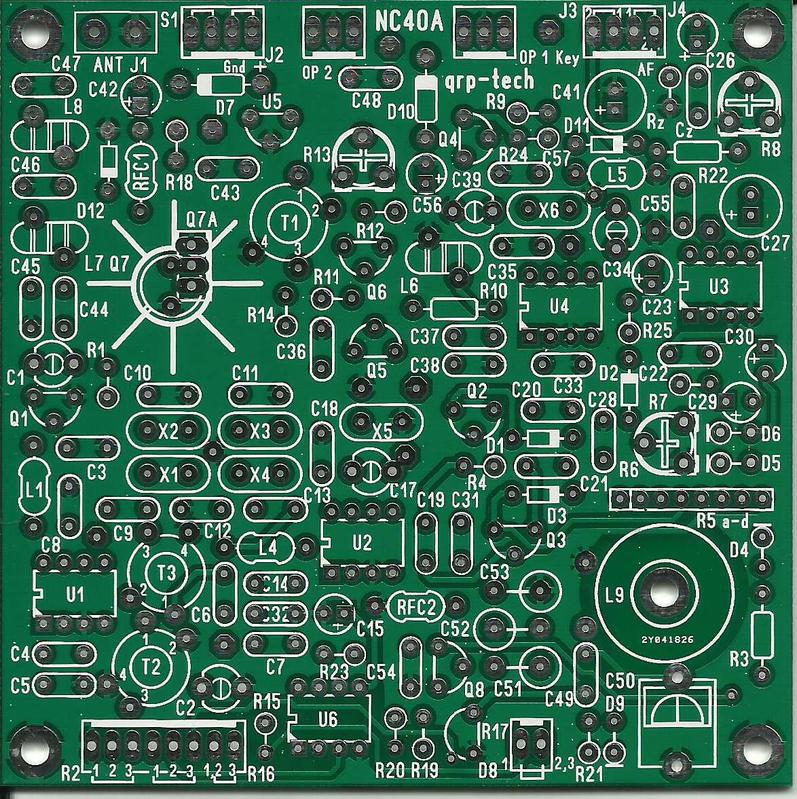
nc40a/NC40A_PCB_front.jpg
