LZ1DPN/NorCal-NC40a/nc40a/smd/NC40XtalFilter.gif

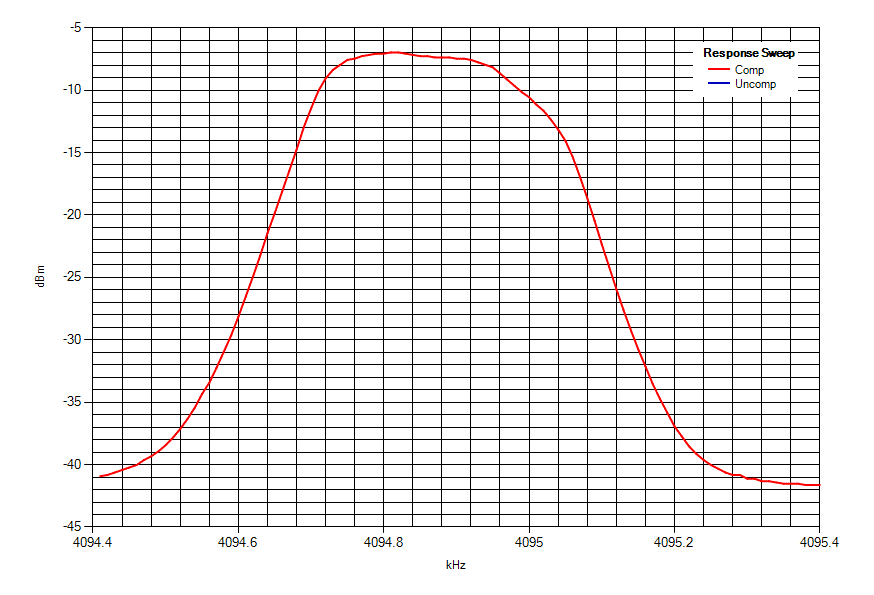
nc40a/smd/NC40XtalFilter.gif
