LZ1DPN/NorCal-NC40a/NorCal40aVFO/other/AD9833 Signal Generator_bb.jpg

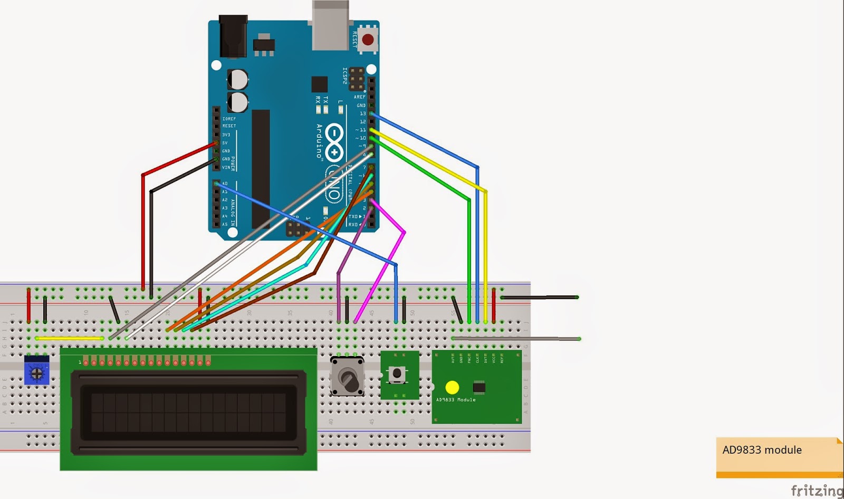
NorCal40aVFO/other/AD9833 Signal Generator_bb.jpg
