LZ1DPN/NorCal-NC40a/nc40a/parts-list.pdf

## Appendix A: NorCal 40A parts List Rev. F, 12-8-1999

)

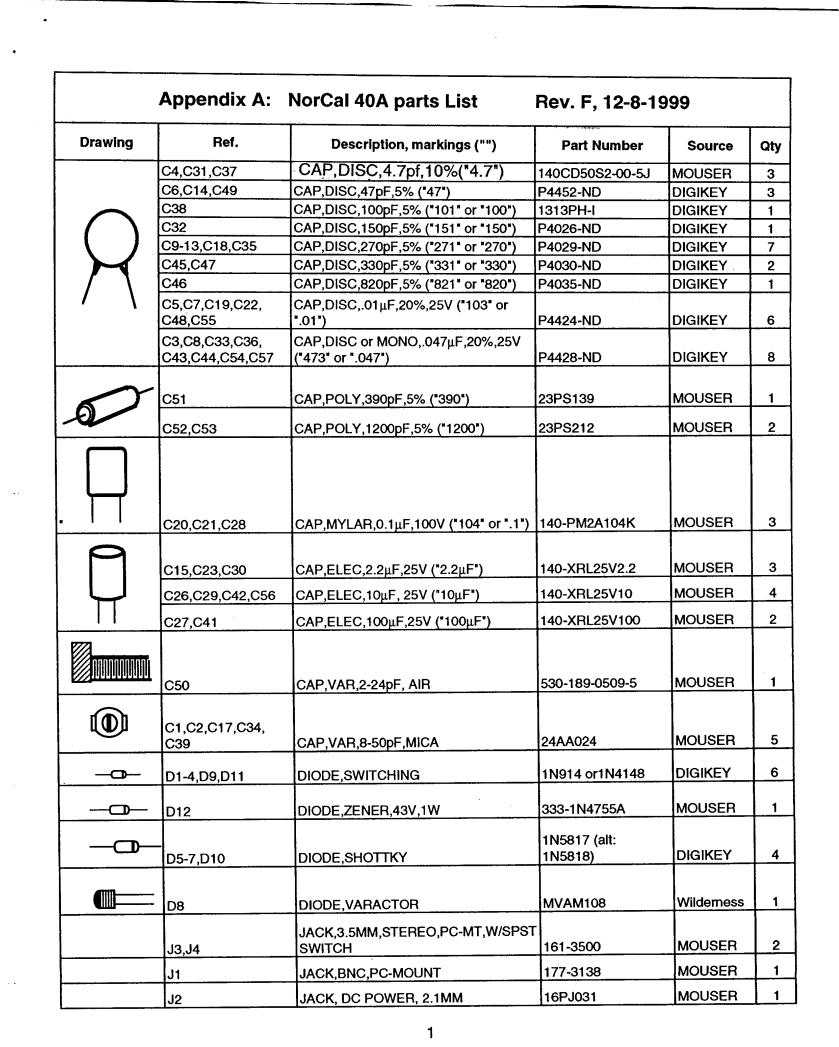
[picture p39: page 1]
Drawing; Ref.; Description, markings (""); Part Number; Source; Qty; .CAp,DISC,4.7pf, 10%("4.7"); 140CDSOS2-QO-5J; MOUSER; CAP,DISC,47pF,S% ('47"); DIGIKEY; CAP,DISC, 100oF,S% ("101" or "100'); CAP,DISC, lS0pF,5% ('151' or "lS0'); CAP,DISC,270pF,5% ("271' or '270'); CAP,DISC,330oF,S% ("331' or '330'); CAP,DISC,820oF,5% ('821' or '820'); CAP,DISC,.01IlF,20%,2SV ("103' or; C48,CSS; CAP,DISC or MONO,.047IlF,20%,25V; £7 CSl; CAP,POLY ,390pF ,5% ('390'); CAP,POLY,1200oF,S% ('1200')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

JACK,3.5MM,STEREO,PC-MT,W/SPST

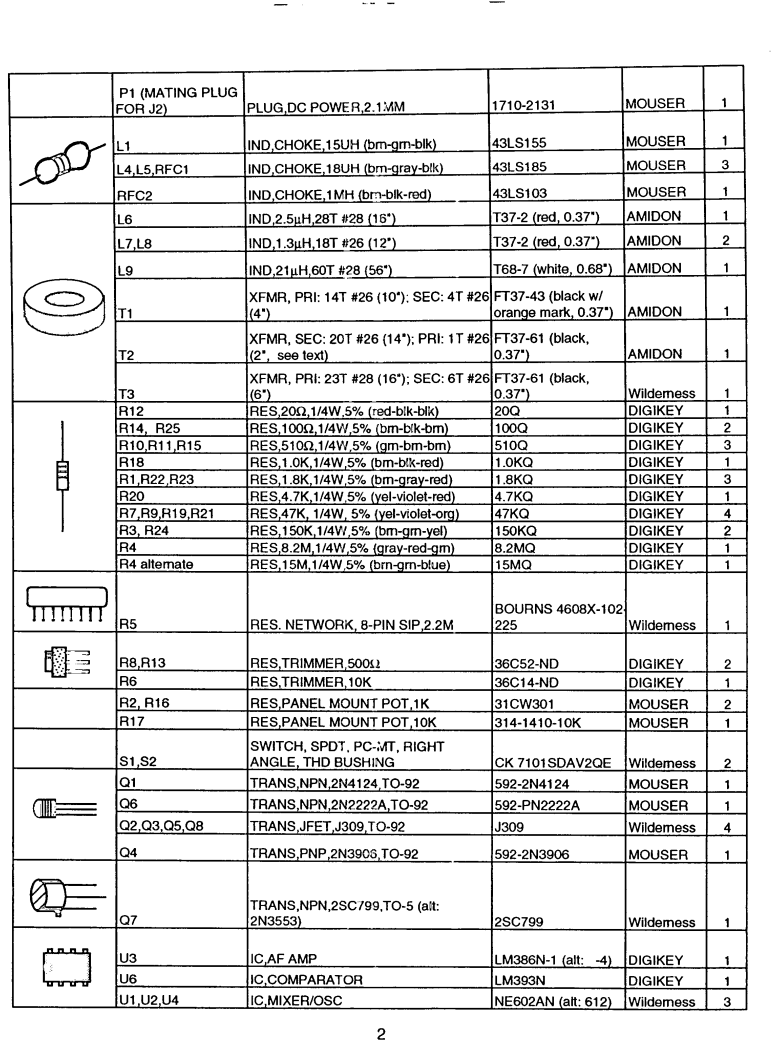
[picture p40: page 2]

XFMR, SEC: 20T #26 (14.); PRI: 1T #26 FT37-61 (black,

XFMR, PRI: 23T #28 (16.); SEC: 6T #26 FT37-61 (black,

SWITCH, SPOT, PC-;v1T,RIGHT

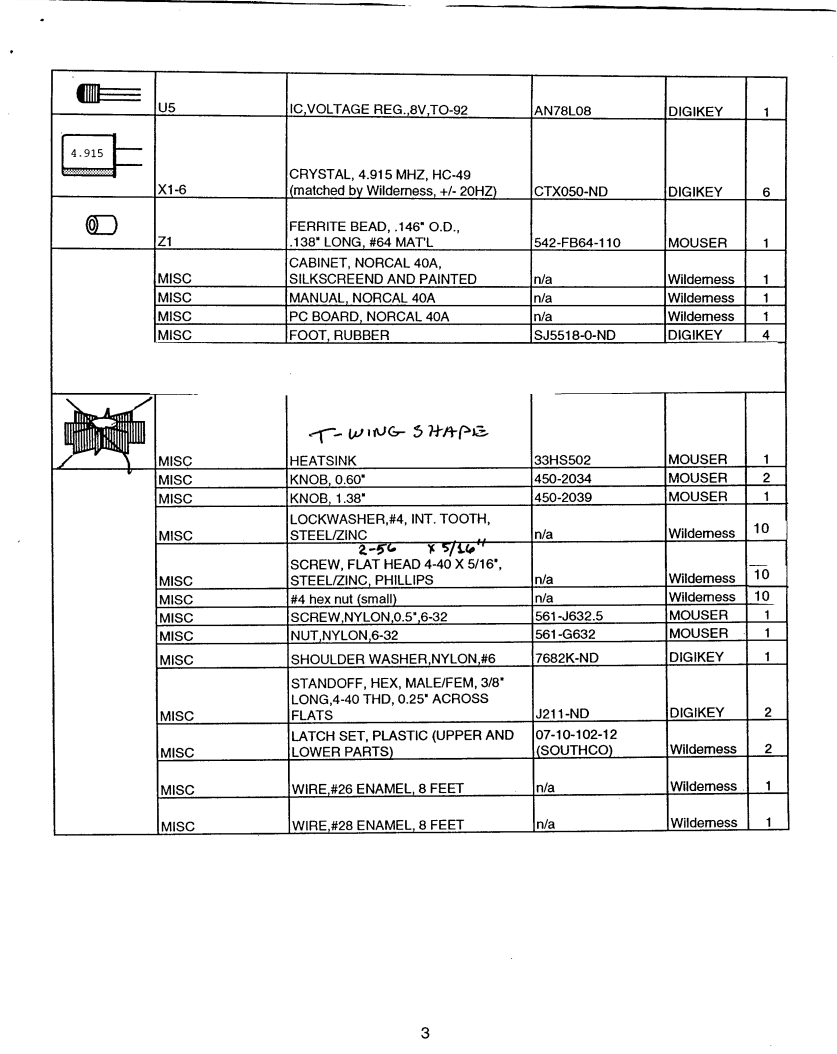
[picture p41: page 3]
IC.VOLTAGE REG.,8V TO-92; DIGIKEY; CRYSTAL, 4.915 MHZ, HC-49; 'matched by Wilderness. +/- 20HZ); CTX050-ND; FERRITE BEAD, .146" O.D.,; .138" LONG #64 MAT'L; MOUSER; CABINET, NORCAL 40A,; MISC; SILKSCREEND AND PAINTED; Wilderness; MANUAL NORCAL 40A; PC BOARD NORCAL 40A; FOOT RUBBER; -1- l)JllVC:r :) H-ItP~; HEATSINK; KNOB 0.60"; KNOB 1.38"; 10 MISC; STEELIZINC; SCREW, FLAT HEAD 4-40 X 5/16",; STEELIZINC. PHILLIPS; #4 hex nut (small); SCREW,NYLON 0.5',6-32; NUT NYLON 6-32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

LOCKWASHER,#4, INT. TOOTH,

STANDOFF, HEX, MALE/FEM, 3/8'
LONG,4-40 THO, 0.25' ACROSS
