LZ1DPN/NorCal-NC40a/nc40a/NC40AFront_EndV1R0_Schematic.pdf

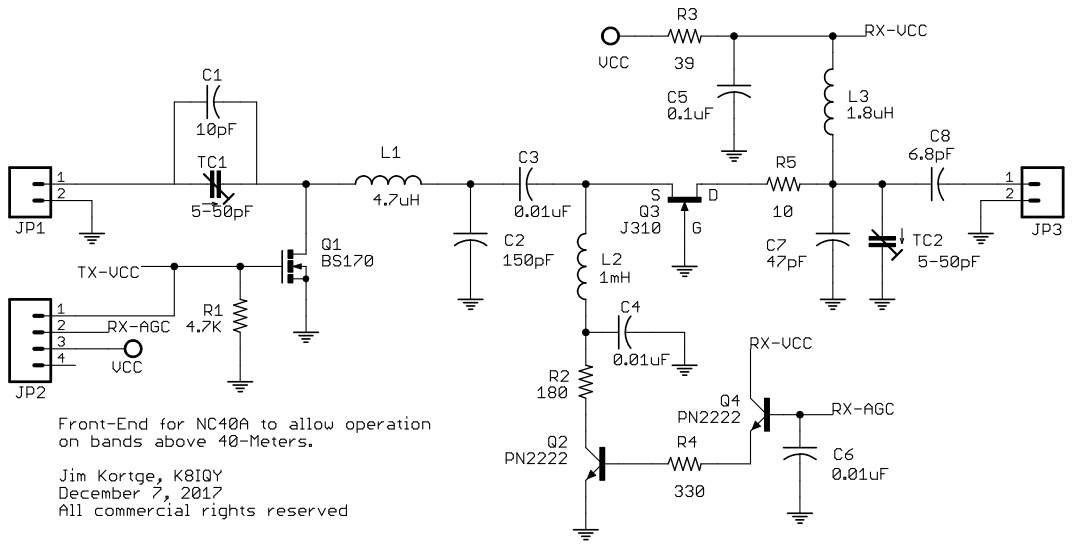
[picture p42: page 1]
