LZ1DPN/NorCal-NC40a/AD9833.pdf

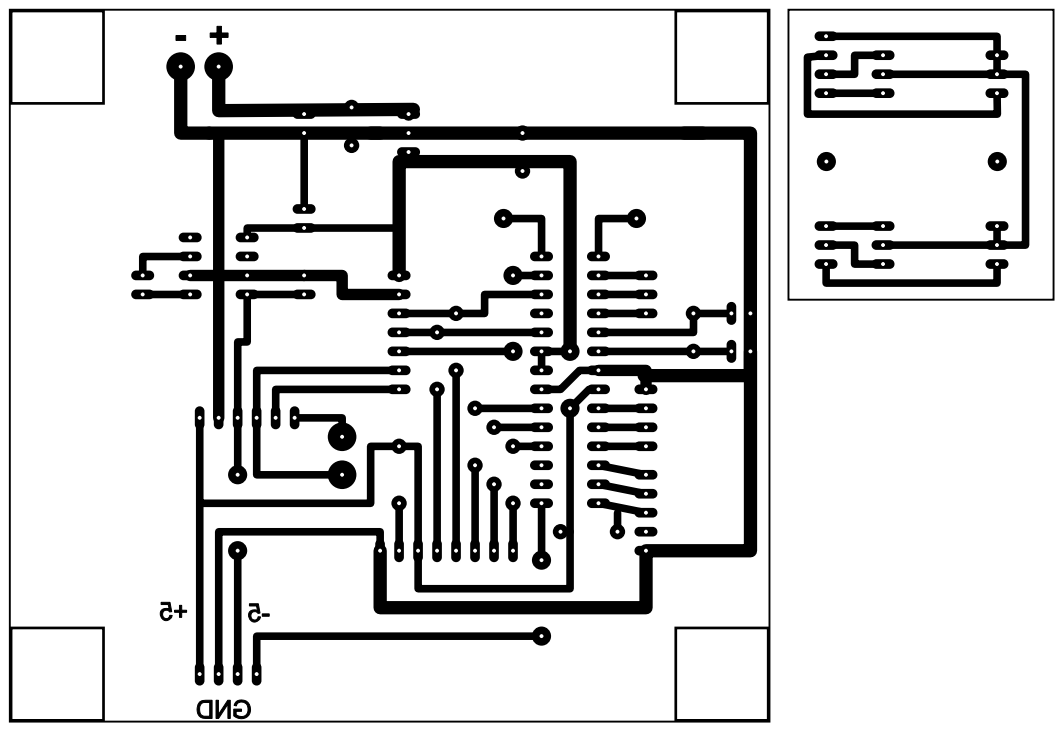
[picture p43: page 1]
