LZ1DPN/NorCal-NC40a/(list of files, drawings)

Other design files:
nc40a/smd/NC40a_SMD_RevE.pcb
