LZ1DPN/NorCal-NC40a/(commit log)

2018-01-21 22.01.2018
    22.01.2018
    [NC40a_SMD_RevE.pcb, NorCal40a DigiKey shopping basket 20171113 Vers 1.6.csv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]
2018-04-07 07.04.2018
    07.04.2018
    [xtals4mhz2.xls]
2019-06-15 15.06.2019
    15.06.2019
    [xtals4915mhz3.xls]
